redwan2003-bot/Kerf_Keeb/hardware/dongle/kerf_dongle_BOM_JLC.csv

Comment | Designator | Footprint | LCSC Part #
12pF 0402 C0G | C1,C2 | 0402 | C1547
1pF 0402 C0G | C3 | 0402 | C1550
1.2pF 0402 C0G | C4 | 0402 | C1551
1.5pF 0402 C0G | C5 | 0402 | C1552
4.7uF 0603 X5R | C6,C16,C17,C18 | 0603 | C19666
100nF 0402 X7R | C7,C8,C9,C11,C14 | 0402 | C56392
1uF 0402 X5R | C10,C13 | 0402 | C52923
100pF 0402 C0G | C12 | 0402 | C1546
1nF 0402 X7R | C15 | 0402 | C1523
FC-B1010RGBT-HG RGB LED | D1 | 1010 RGB | C158099
USB4155-03-C USB-C | J1 | USB4155-03-C | C5183853
4.7nH LQG15HS4N7S02D | L1 | 0402 | C86065
2.2nH LQG15HS2N2S02D | L2 | 0402 | C86061
5.1k 0402 | R1 | 0402 | C25905
330R 0402 | R3,R4,R5 | 0402 | C25104
0R 0402 | R6 | 0402 | C17168
TS-1088-AR02016 tact switch | SW1 | SMD 3.9x3.0 | C720477
nRF52833-QDAA-R | U1 | QFN-40 5x5 | C2895249
USBLC6-2SC6 | U2 | SOT-23-6 | C7519
32MHz NX2016SA | X1 | 2016 4-pad | C5441424
