redwan2003-bot/Kerf_Keeb/hardware/keyboard/kerf_keeb_BOM_JLC.csv

Comment | Designator | Footprint | LCSC Part #
1N4148W | D1,D2,D3,D4,D5,D6,D7,D8,D9,D10,D11,D12,D13,D14,D15,D16,D17,D18,D19,D20,D21,D22,D23,D24,D25,D26,D27,D28,D29,D30,D31,D32,D33,D34,D35,D36,D37,D38,D39,D40,D41,D42,D43,D44,D45,D46,D47,D48,D49,D50,D51,D52,D53,D54,D55,D56,D57,D58,D59,D60,D61,D62,D63,D64,D68 | SOD-123F | C81598
100nF 25V X7R (FH 0402B104K250NT) | C1,C2,C3,C4,C5,C6,C7,C8,C9 | 0402 | C56392
10uF 10V X5R (CL10A106KP8NNNC) | C10,C11 | 0603 | C19702
JST S2B-PH-SM4-TB battery connector | J2 | PH 2.0mm SMD 2P | C295747
WS2812B-B/W | LED1,LED2,LED3,LED4,LED5,LED6,LED7,LED8 | 5050-4P | C114586
AO3401A P-MOSFET | Q1,Q3 | SOT-23 | C15127
AO3400A N-MOSFET | Q2 | SOT-23 | C20917
330R 0402 (0402WGF3300TCE) | R1 | 0402 | C25104
100k 0402 (0402WGF1003TCE) | R2,R3,R4 | 0402 | C25741
MSK12C02 slide switch | SW66 | SMD side slide | C431540
TS-1187A-B-A-B tact switch | SW67 | SMD 5.1x5.1 | C318884
74HC595D | U2 | SOIC-16 | C5947
