redwan2003-bot/Kerf_Keeb/mechanical/knob/lp63_ec12_knob.step

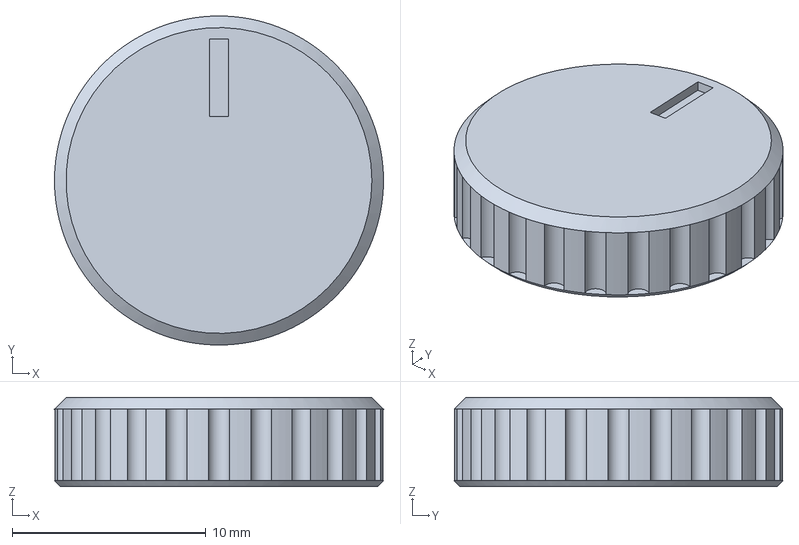
[picture p5: CAD file, 2026-11-03]
mechanical/knob/lp63_ec12_knob.step
17.0 x 17.0 x 4.60 mm
