redwan2003-bot/Kerf_Keeb/mechanical/plate/lp63_plate_fit_coupon.step

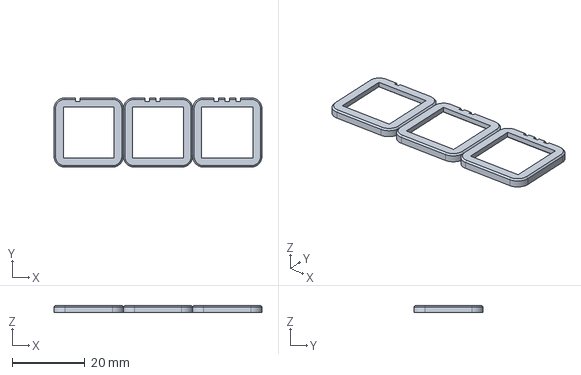
[picture p6: CAD file, 2026-11-04]
mechanical/plate/lp63_plate_fit_coupon.step
57.1 x 19.1 x 2.00 mm
