redwan2003-bot/Kerf_Keeb/mechanical/reference/ks33_with_hotswap_socket.step

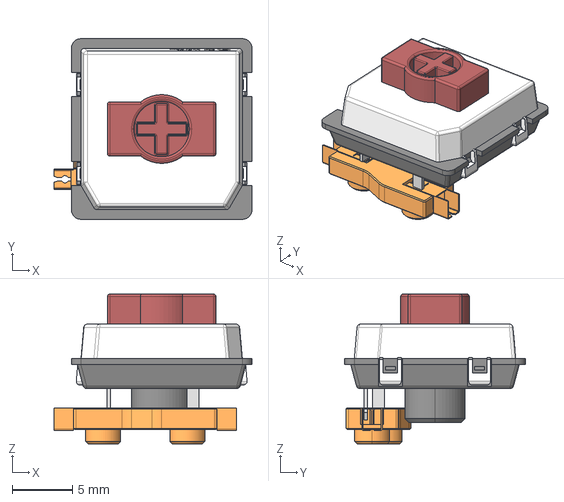
[picture p7: CAD file, 2026-11-03]
mechanical/reference/ks33_with_hotswap_socket.step
16.4 x 15.0 x 12.4 mm
SW-TH_KS-33H10B050NN-Y24
LP2_socket_C9900059694
