redwan2003-bot/Kerf_Keeb/mechanical/plate/lp63_plate.step

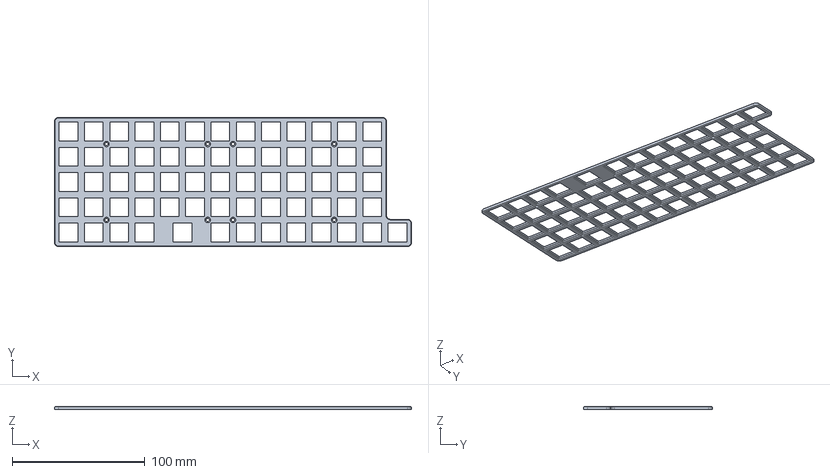
[picture p8: CAD file, 2026-11-04]
mechanical/plate/lp63_plate.step
268.7 x 97.3 x 2.00 mm
