redwan2003-bot/Kerf_Keeb/(list of files, cad)

Other CAD files:
mechanical/knob/lp63_ec12_knob.stl
mechanical/plate/lp63_plate.stl
mechanical/plate/lp63_plate_fit_coupon.stl
