redwan2003-bot/Kerf_Keeb/(commit log)

2026-11-03 Add kerf_keeb hardware, firmware, mechanical files and documentation
    - README with features, keymap, repo layout, status and build guide
    - hardware/: JLCPCB BOM/CPL for keyboard and dongle, logo artwork, pin map and power design
    - firmware/: BLE (ZMK v0.3) and ESB (ZMK main + split-esb) configs, prebuilt UF2s (BLE v11, ESB v7), dongle bootloader
    - mechanical/: 3D-printable switch plate with fit coupon, EC12 knob, KS-33 reference model
    - docs/: ordering guide, production readiness audit, Kerf Hub software plan
    Claude-Session: https://claude.ai/code/session_01G1RwYkoeDPgz7bqjVFKcVs
    [kerf_dongle_BOM_JLC.csv, kerf_keeb_BOM_JLC.csv, ks33_with_hotswap_socket.step, lp63_ec12_knob.step, lp63_ec12_knob.stl, lp63_plate.step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]
2026-11-04 Remove the top-side battery LED (LED9)
    - PCB/schematic: LED9 removed, LED8 DOUT no-connect, LED_VCC trunk to LED7 kept
    (107 nets, 385 pins, 163 parts; DRC 0, schematic = PCB)
    - Firmware: batled behaviour, kerf_batled and kerf_led_split removed; 8-LED chain;
    Fn+Esc = Esc. All BLE and ESB targets rebuilt (BLE v12, ESB v8)
    - Plate: LED9 window removed (STEP/STL regenerated)
    - Docs, keymap image and plate preview updated
    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
    [lp63_plate.step, lp63_plate.stl, lp63_plate_fit_coupon.step]
2026-11-05 Fix knob: EC12E1240301 has no push switch
    The SW65 D/E pads are the encoder's mounting lugs, so the ENC_SW wiring
    shorted D18 to GND through the bracket. Lugs are now both GND, ENC_SW
    removed from schematic, PCB and firmware (8-row matrix, 65 bindings).
    Also removed dead BAT+/RST/GND copper stubs and an orphan via, fixed
    schematic notes, and rebuilt all firmware (BLE v13, ESB v9).
    Verified: PCB DRC 0, schematic DRC 0, schematic = PCB (106 nets,
    384 pins, 163 parts), no dangling copper. Gerbers exported 2026-11-05.
    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
2026-11-05 ORDERING: name the final 2026-11-05 Gerber files
    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
